Deffendor/slidar/documentation/reports/prestudy/slidar-prestudy.tex

\documentclass{article}
\usepackage[utf8]{inputenc}
\usepackage{graphicx}
\title{\\
Construction of the Slidarr}

\author{Mats Jonsson, Sören Meinken, Mohammad El Musleh}
\date{March 2019}

\begin{document}

\maketitle

\section{Introduction}
\paragraph{}The idea is to create a new revolutionary music instrument called Slidarr. It originated from the guitar instrument but instread of using it the regular way of pulling the strings, the fingers will slide on the strings without the strings making any sound. The sound will come from the relative location of the fingers on the strings which will be determined by the electronic equipment developed in this project.

\paragraph{}Since the construction of the actual instrument is very simple, just some strings and wires, it can be built in many different ways. For example, it can be attached to a steel-stringed guitar but also built as a one-stringed guitar or like a violin with a conductive bow.

\section{Objectives}
\paragraph{}On a guitar, there are usually six strings, but this instrument only needs one or two strings to operate. In addition to that, the project will be started using optimal conditions for the strings and the conductor on the hand. This means using a very good conductor on the finger to bridge the strings so that the biggest resistance is the length of the wires. If this works, the next move would be to use bare hands with possibly other strings that have a similar resistance. Once the MIDI data is created from the ADC there are several options what to do with it e.g. sending it to a computer to synthesize via USB, wirelessly or synthesize the signal on chip.

\begin{figure}[h]
  \centering
  %  \vspace*{-0.15in}
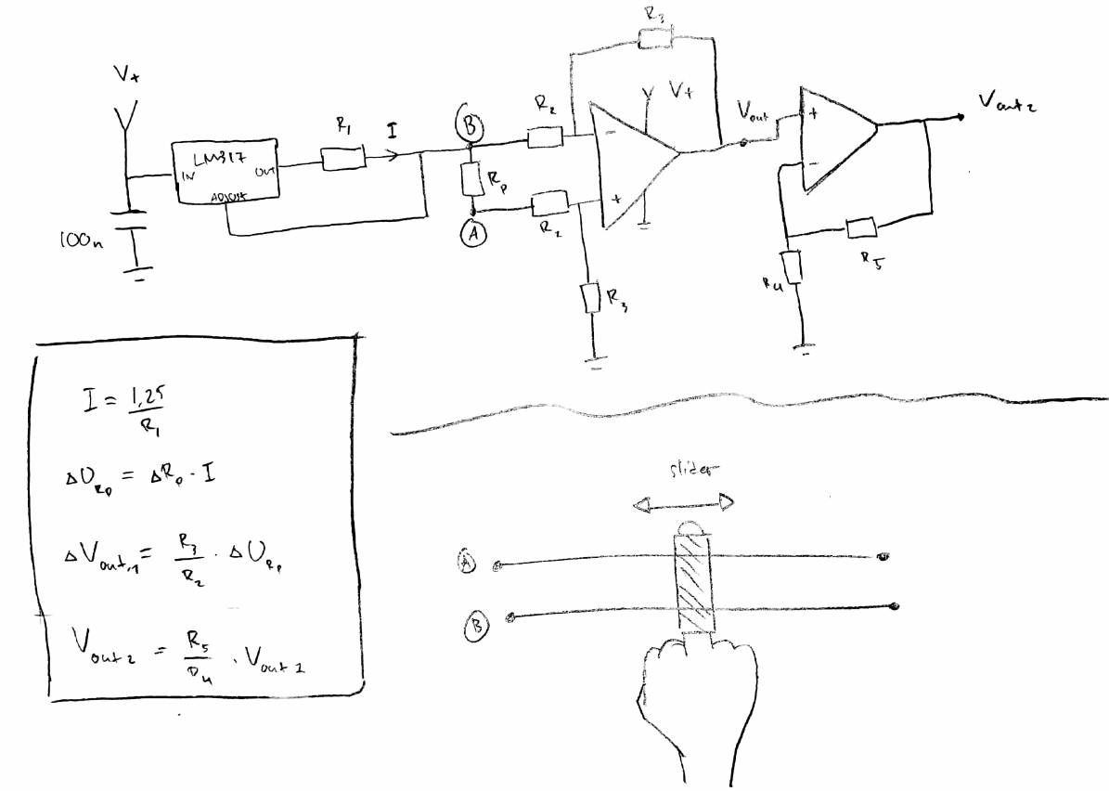
[picture p7: documentation/reports/prestudy/circuit.png]
  
  \caption{Circuit diagram and principal sketch for the Slidarr.}
  \label{fig:circuit}
\end{figure}

\section{System overview}
\paragraph{}The Slidarr senses tiny changes in resistance and translates it to MIDI commands, before sending them over USB to a computer running a software synth that produces the audio. The instrument's interface will consist of a metal wire with a constant current running through it. See figure \ref{fig:circuit}. The artist touches the wire at any position with a conductor, further called the "finger", that reads a tiny voltage drop depending on its position along the wire. The voltage drop between A and B is amplified using the presented circuit, and fed into an ADC converter on the ARM Cortex that translates the signal to the corresponding MIDI note. 

\subsection{User interaction}
\paragraph{}When the finger makes contact with the string, the system sends a "note on" event. The finger can now slide along the wire, resulting in continuous "pitchbend" events that are able to change the frequency of the tone generated by the synth. When the finger is released, a "note off" event is sent.

\paragraph{}A button implements a scrolling feature. When the button is pressed, sliding the finger along the string will "scroll" the frequency range covered by the string up or down the scale, allowing the artist to reach higher or lower notes with just a short string.

\subsection{Calibration}
\paragraph{}The artist should be able to calibrate the system. Another button lets the artist define two positions of the string that corresponds to one octave.

\section{Organisation}
\paragraph{}There are five major parts in this a project to be realized to achieve project concept in Figure~\ref{myfigure}.
\begin{itemize}
    \item Creating/developing a measurement circuit to read the resistance(distance) from the strings
    \item Read that signal with an ADC
    \item Convert the signal to proper representation for the MIDI protocol
    \item Send the signal to a synthesizer
    \item Calibration and setting of modes
\end{itemize}
\begin{figure}[h]
\centering
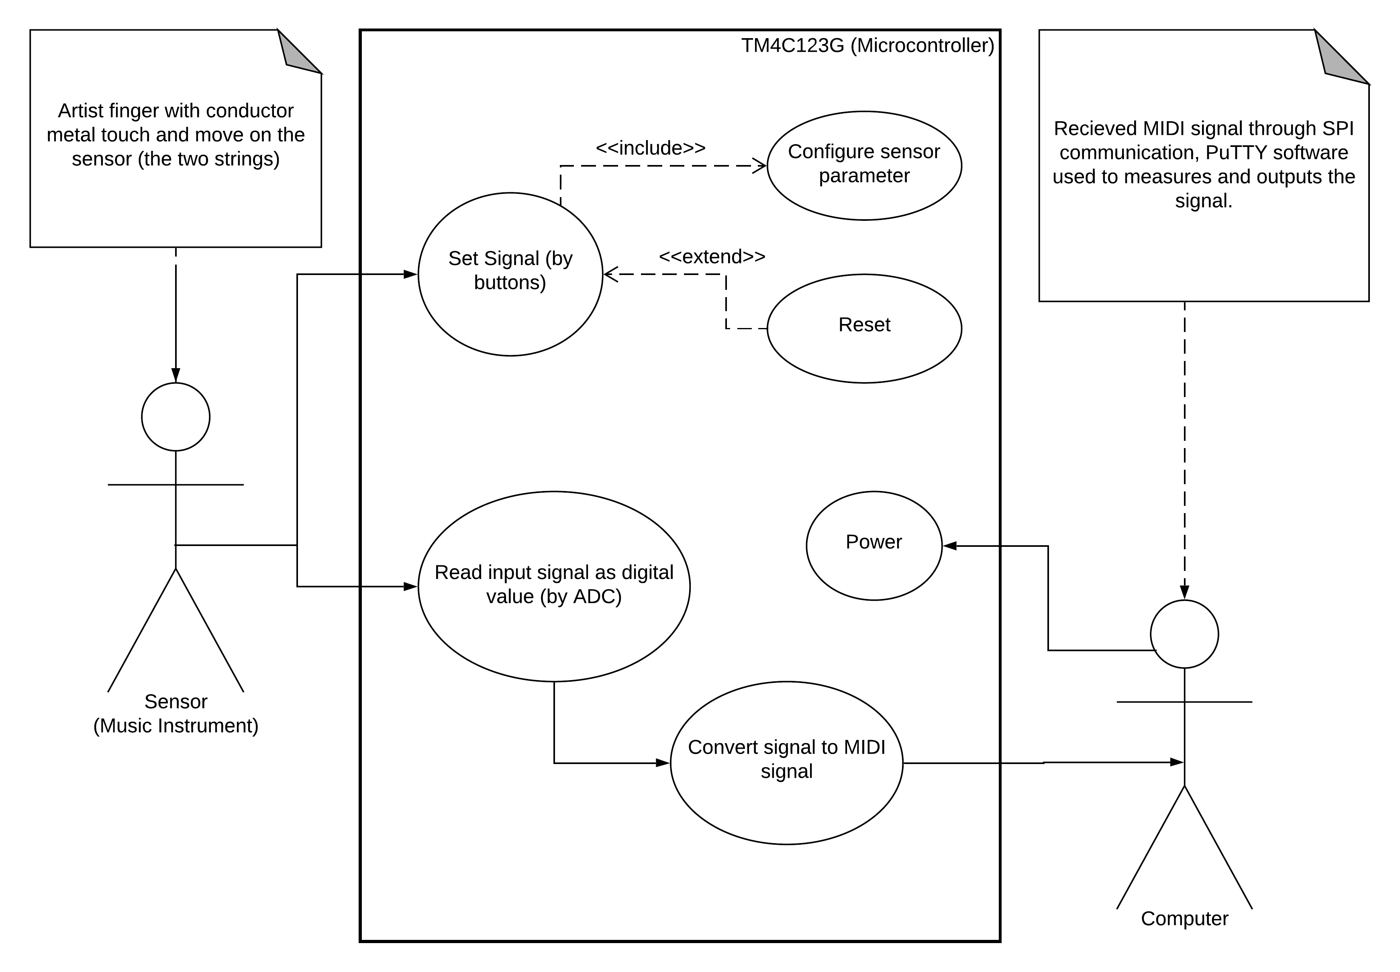
[picture p8: documentation/reports/prestudy/PESUML.png]

\caption{A use case diagram of Slidarr project}
\label{myfigure}
\end{figure}
\paragraph{}The five major parts mentioned before can all be developed on in parallel. There will be three people working available to work on this project.

\section{Hardware Required}
\begin{itemize}
    \item Circuit consists of resistors, capacitors, transistors, strings, screws, buffer amplifier, breadboard and jumper wires.  
    \item Microcontroller TM4C123G – ADC (Dual 12-bit 2MSPS ADCs)
    \item Speaker, Buttons and LEDs (maybe we add potentiometer and LCD)
    \item Serial Communication between MCU and PC (maybe transmitter signal by WiFi module)
\end{itemize}

%\section{Method}

\section{Challenge}

\paragraph{}The possible challenges:
\begin{itemize}
    \item Building the circuit that gives a proper signal.
    \item Making accurate ADC readings from the strings.
    \item Setup the communication using the MIDI protocol.
    \item Noise in case the strings are not connected with each other.
\end{itemize}
\end{document}
