Deffendor/slidar/documentation/slider-circuit.pdf

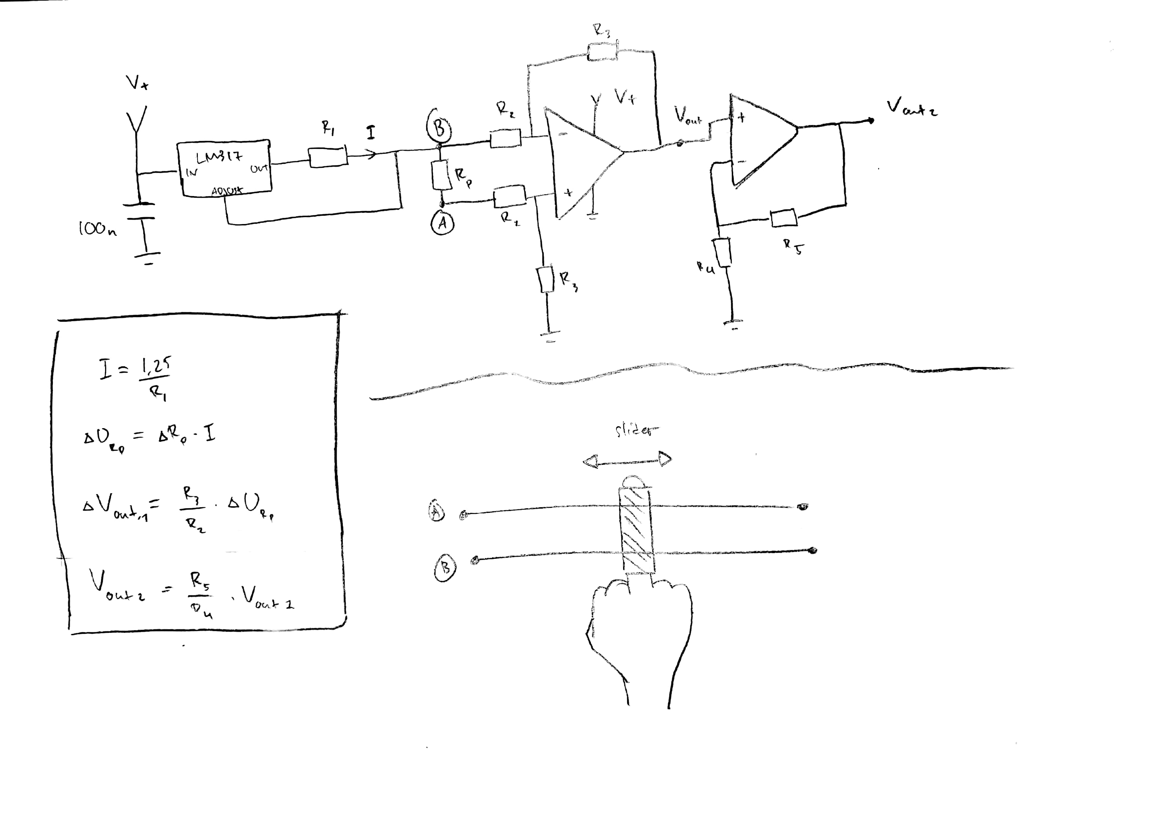
[picture p9: figure]
