Deffendor/slidar/documentation/circuit/Slidarr_final_B_bb1.png

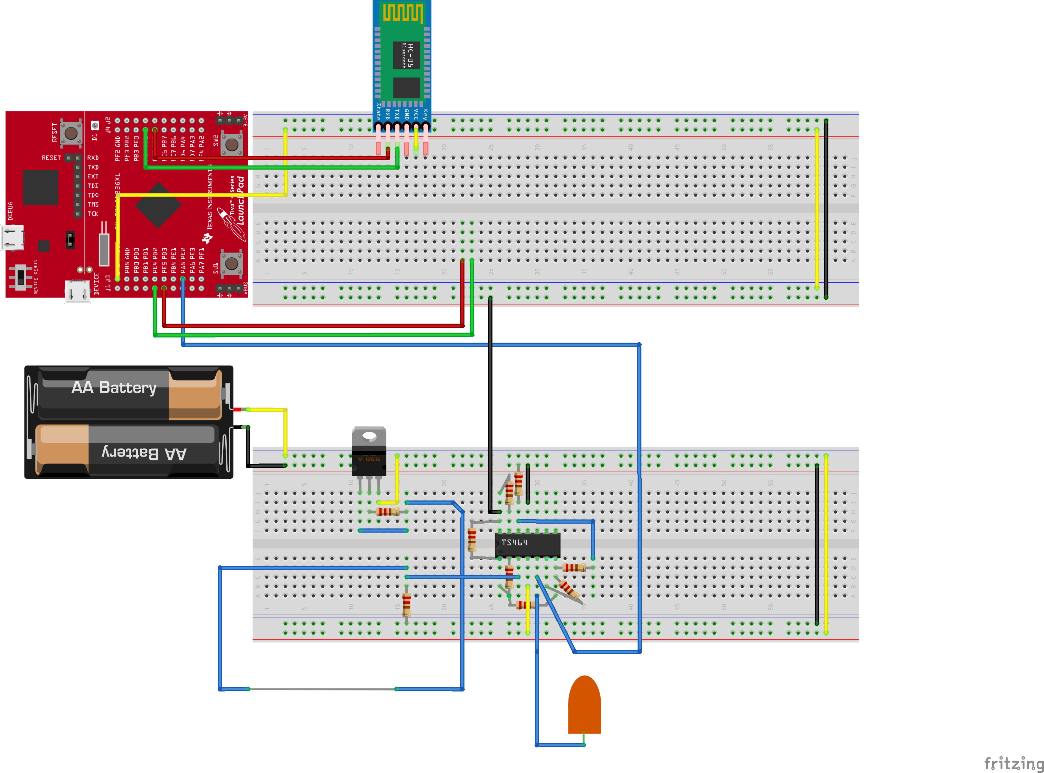
documentation/circuit/Slidarr_final_B_bb1.png
