Deffendor/slidar/documentation/circuit/Slidarr_final_B_schem.png

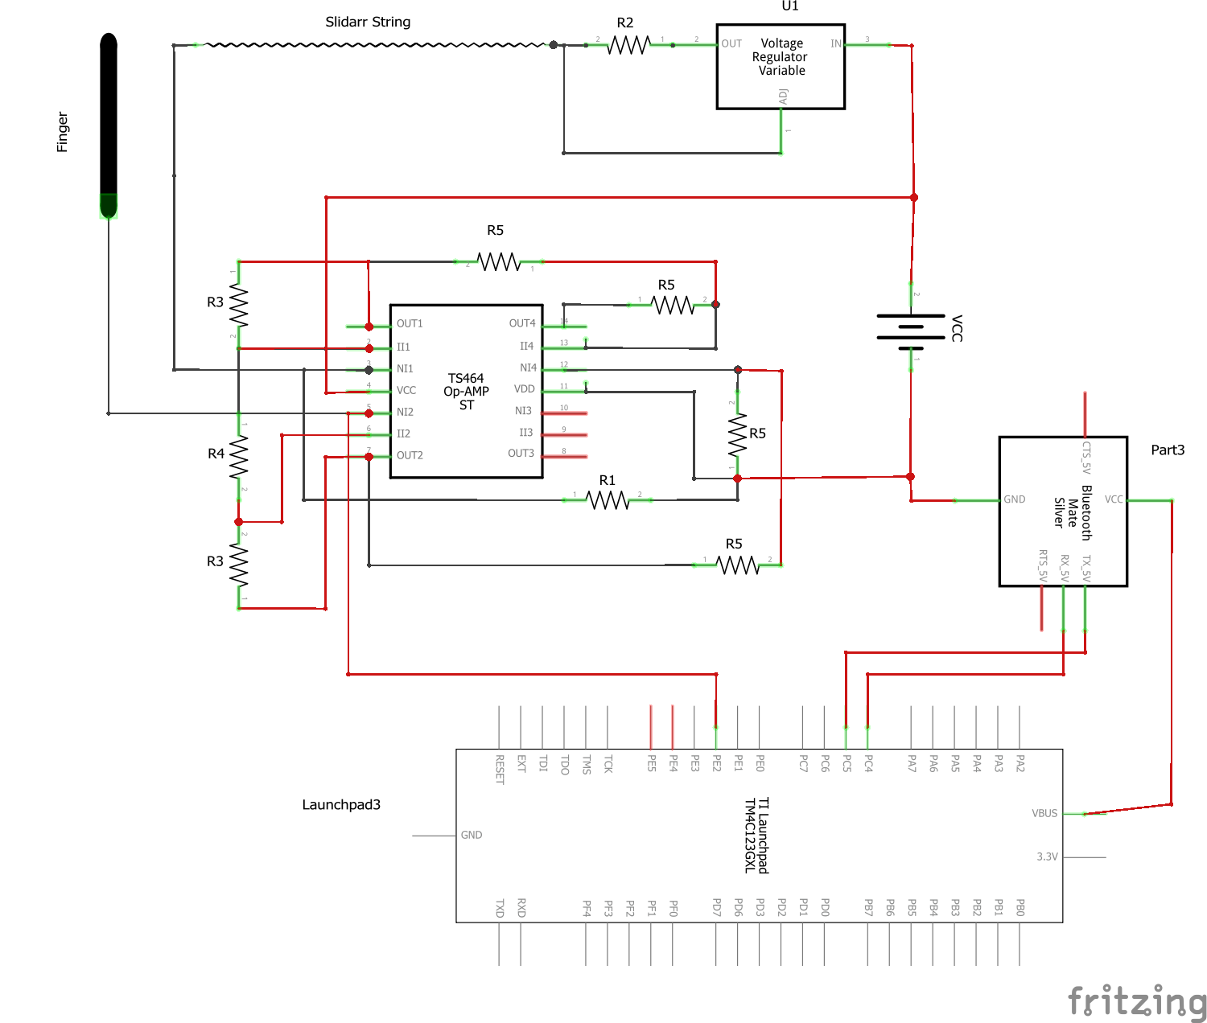
documentation/circuit/Slidarr_final_B_schem.png
