Deffendor/slidar/documentation/circuit/Slidarr_final_B_schem_des.jpg

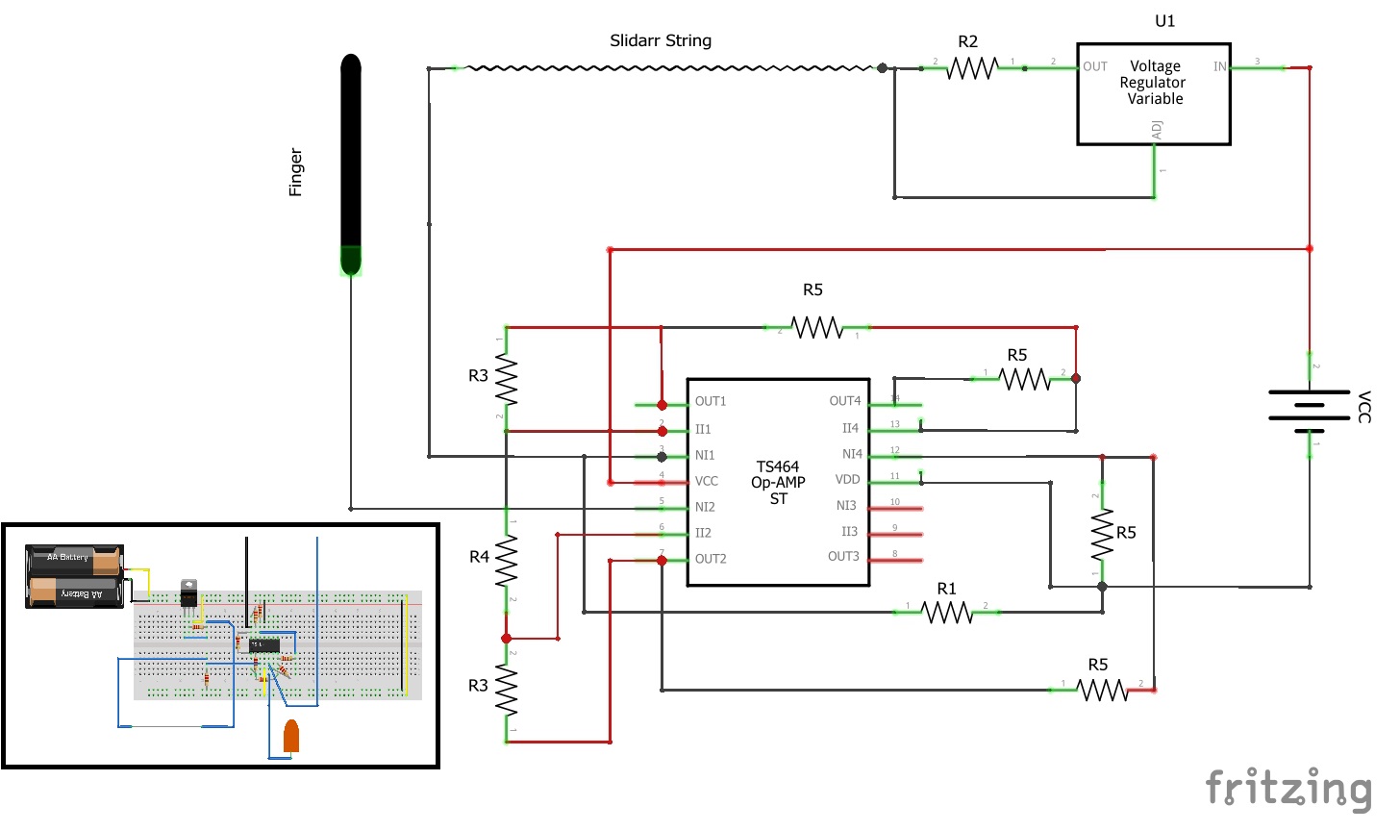
documentation/circuit/Slidarr_final_B_schem_des.jpg
