Deffendor/slidar/documentation/reports/report/Kelvin_Connections.jpeg

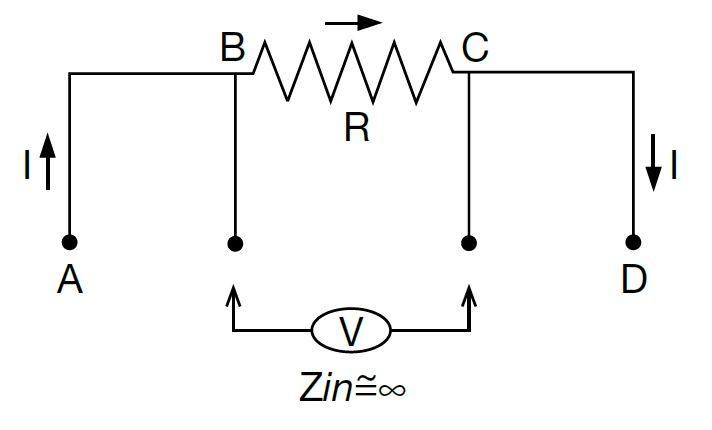
documentation/reports/report/Kelvin_Connections.jpeg
