Deffendor/slidar/documentation/reports/report/slidarr_2_.jpg

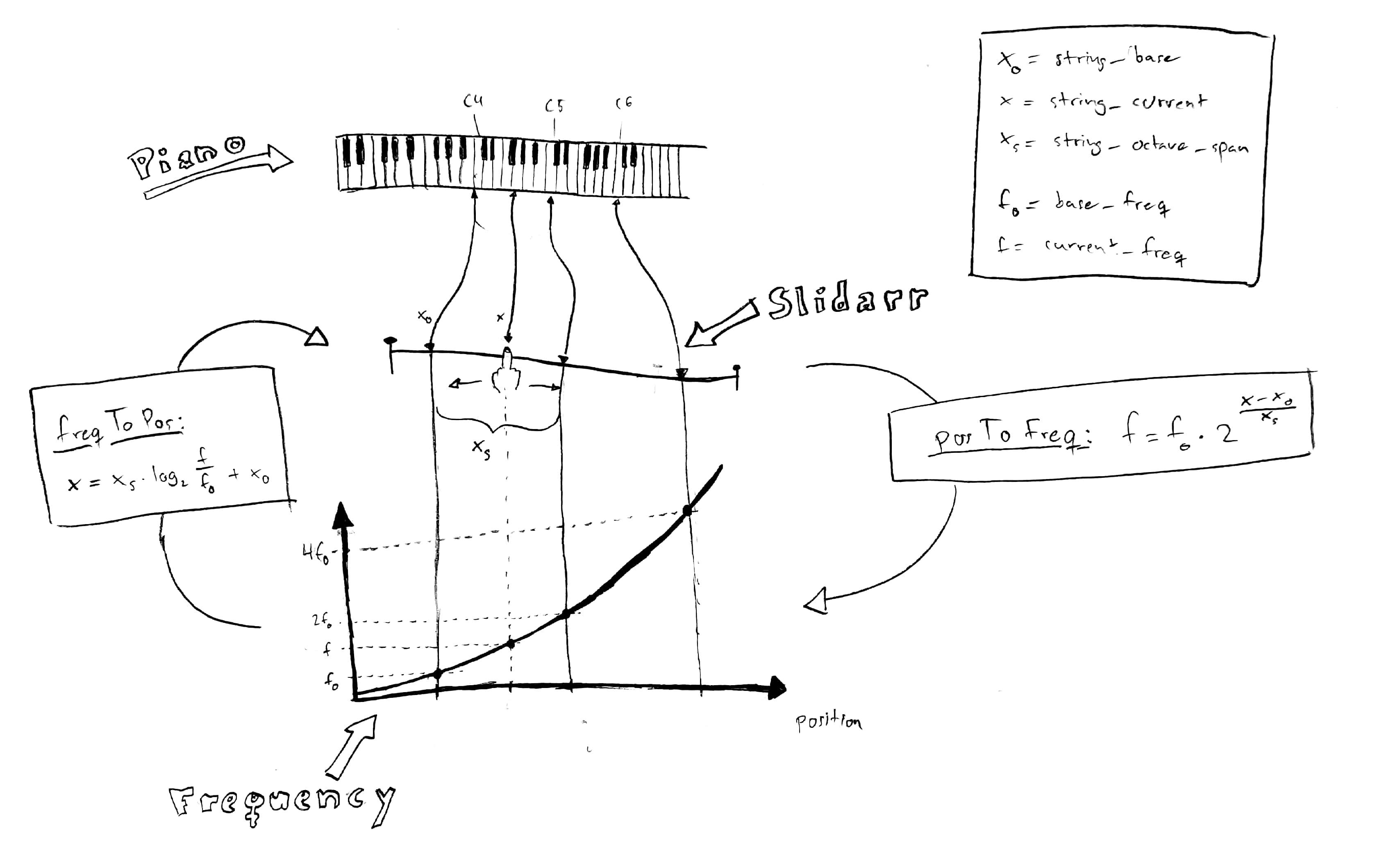
documentation/reports/report/slidarr_2_.jpg
