Deffendor/slidar/documentation/reports/report/string-sensor.jpeg

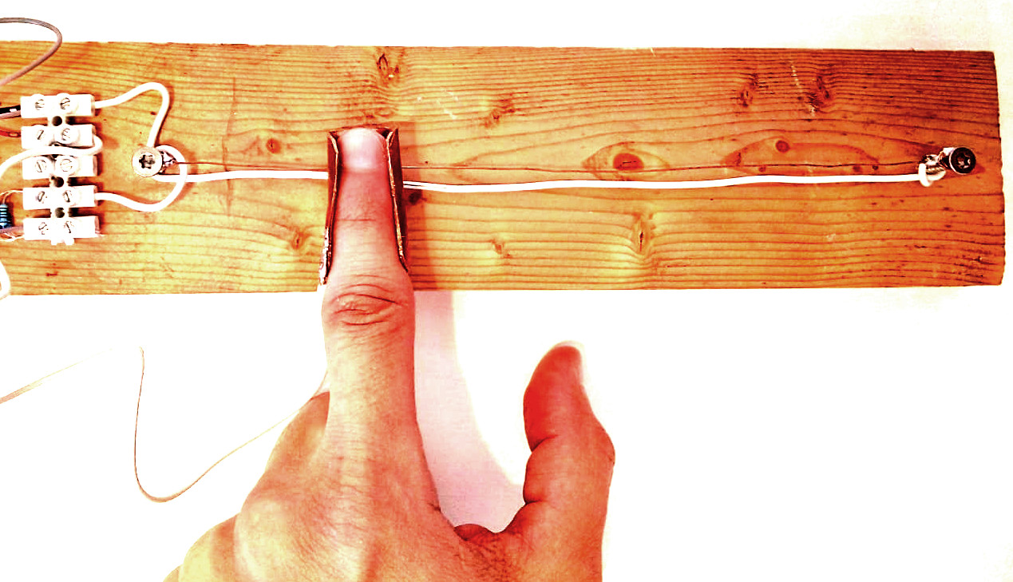
documentation/reports/report/string-sensor.jpeg
