Deffendor/slidar/documentation/todo.md

### ToDo:

Prestudy document:
- project description
- drawings of concept
- use case
- requirements?
- ...
