Deffendor/slidar/documentation/reports/report/slidar_illustration.pdf

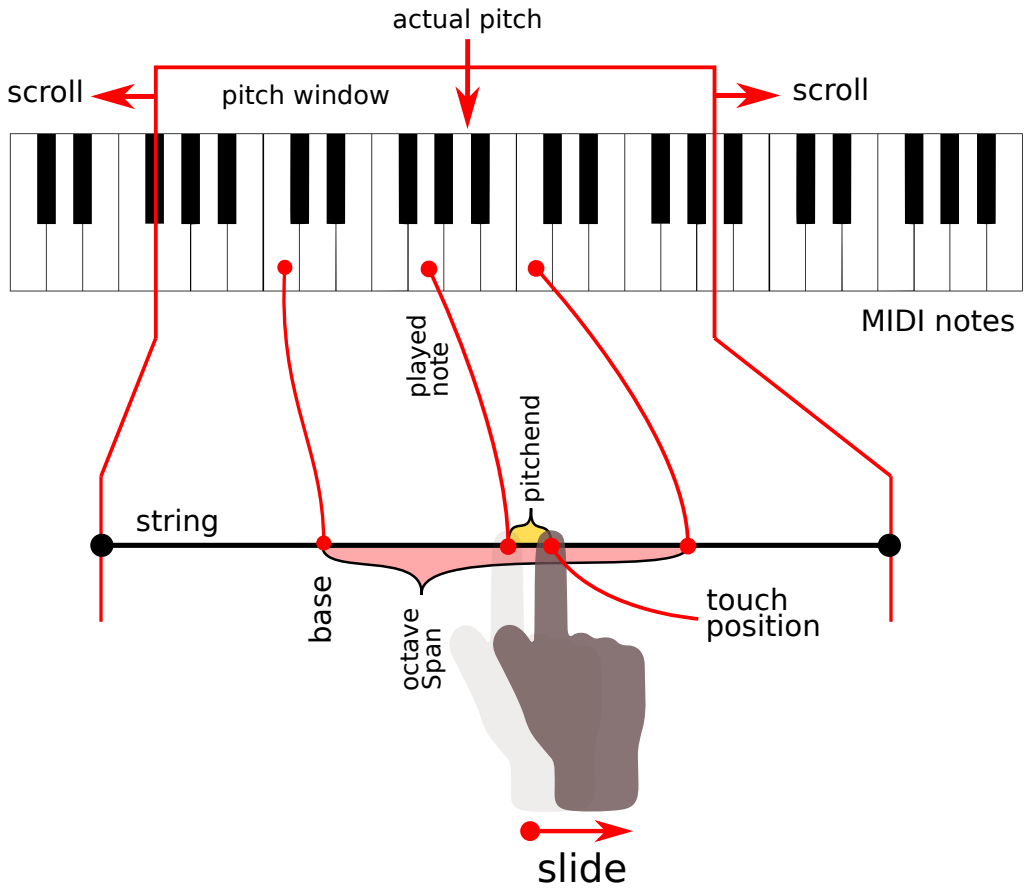
[picture p16: page 1]
scroll; pitch window; slide; base; octave Span; pitchend; string; MIDI notes; played note; position; touch; actual pitch
