Deffendor/slidar/documentation/reports/report/octave.pdf

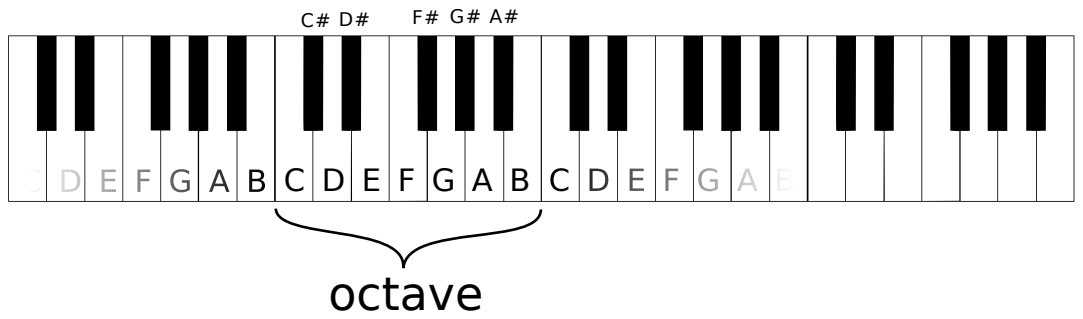
[picture p17: page 1]
octave
