Deffendor/slidar/documentation/reports/report/slidarr-circuit.pdf

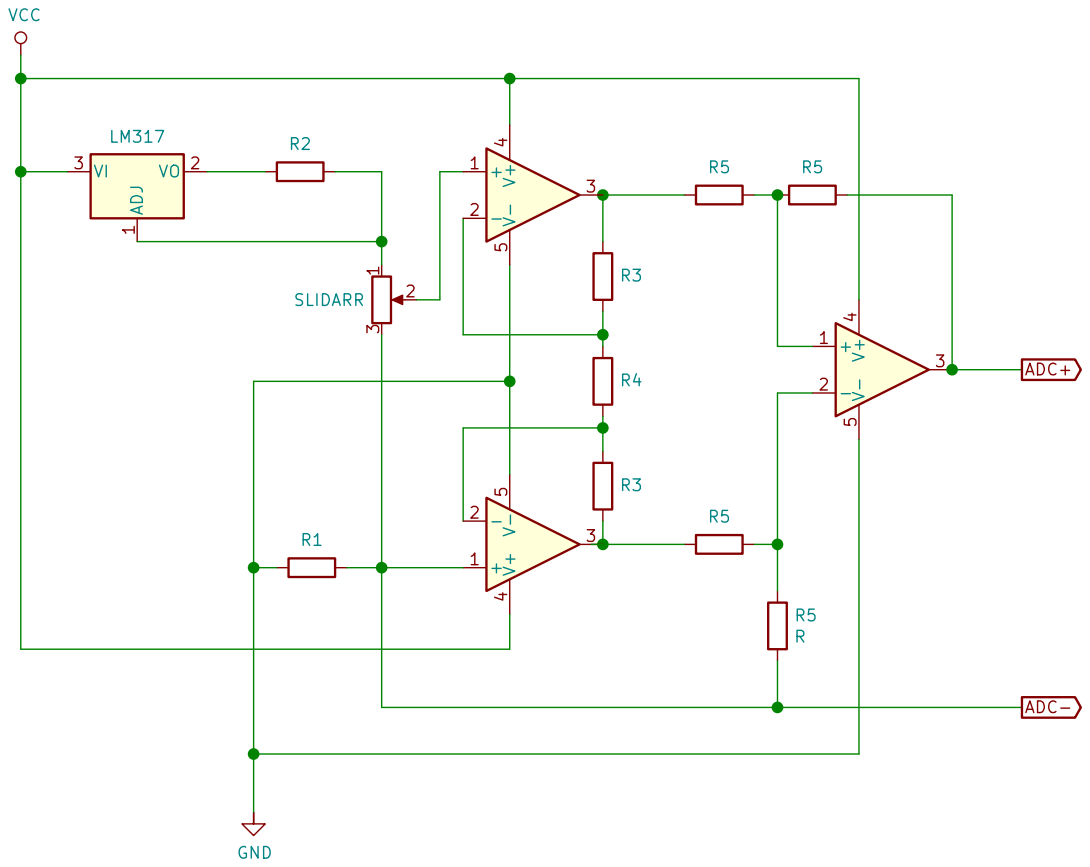
[picture p18: page 1]
