Deffendor/slidar/(commit log)

2019-03-29 Add circuit docs
2019-04-01 musleh
    I added the use case diagram and 3 challenges
2019-04-10 simple bare bones ADC example
2019-04-25 add uart and print raw adc value
2019-05-13 Update adc value by-ref
2019-05-13 Consistent naming of functions, fix header includes
    [adc.c, buttons.c, main.c, slidarr.h, uart.c, uart.h]
2019-05-13 Implement states CALIBRATE_BASE and CALIBRATE_OCTAVE
2019-05-17 added buttons
2019-05-17 Switch to ADC1
2019-05-17 Fix touch sensing and calibration state enter point
    [defaults.h, main.c]
2019-05-20 Improve calibration sequence
2019-05-20 Fix calcFreq and pitchbending
    [defaults.h, main.c, midi.c, slidarr.c]
2019-05-21 added uart5 for wireless and the systick timer
2019-05-22 enable UART FIFO buffer, so the UART doesnt stall
    [uart.c]
2019-05-24 Automatically switch note after max pitchbending
2019-05-24 Fix freqToNote return type
    [midi.c, midi.h]
2019-05-29 read data in interrupt
2019-05-29 switch buttons
2019-05-29 switch buttons back and use blue led for scroll
2019-05-29 button changes, works pretty smooth now
2019-05-30 temporary scroll fix, added comments to variables
    [defaults.h, main.c]
2019-05-31 Fix calculations in posToFreq and freqToPos
    [slidarr.c]
2019-06-01 added the circuits diagram
2019-06-01 switch to laptop
2019-06-01 remove interrupt stuff, some more report
2019-06-01 removed left interrupt
2019-06-01 fix bug in Uart5
    [uart.c]
2019-06-01 modified tx uart5 in midi messages
2019-06-02 write about wireless connection
2019-06-02 report calibration, scrolling testing, result
2019-06-03 Add KiCad circuit
    [slidarr.kicad_pcb, slidarr.sch]
2019-06-03 Replace 4-wire image, rename Design -> Hardware design
